DaneEvans/gecko/(commit log)

2024-08-16 add kicad proj
    [Gecko.kicad_pcb, Gecko.kicad_sch]
2024-08-16 add crkbd proj
    [Gecko.kicad_pcb, Gecko.kicad_sch]
2024-08-28 first pass at the gecko
    [corne-chocolate.kicad_sch, left.kicad_sch, right.kicad_sch]
2024-08-28 rename project files
    [BOM-corne-chocolate.csv, Gecko_choc.kicad_sch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]
2024-08-28 moved subsheets across
    [Gecko_choc.kicad_sch, left.kicad_sch, right.kicad_sch]
2024-08-28 add jumpers to the split pin
    [left.kicad_sch, right.kicad_sch]
2024-08-31 schem check, outline done, drc done
    [left.kicad_sch, right.kicad_sch]
2024-09-02 renumber switches, git status
    [BOM-corne-chocolate.csv, left.kicad_sch, right.kicad_sch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]
2024-09-02 add prod files
    [bom.csv, designators.csv, positions.csv]
2024-09-02 add plate fabs
    [Top_plate-B_Cu.gbr, Top_plate-B_Mask.gbr, Top_plate-B_Paste.gbr, Top_plate-B_Silkscreen.gbr, Top_plate-Edge_Cuts.gbr, Top_plate-F_Cu.gbr, Top_plate-F_Mask.gbr, Top_plate-F_Paste.gbr]
2024-11-19 v0.1 kicad files
    [Gecko_choc_bom.csv, Top_plate.kicad_pcb, bottom_plate.kicad_pcb]
